foldynl/dds_sweeper/arduino/doc/antennenanalysator_m4_schematic.pdf

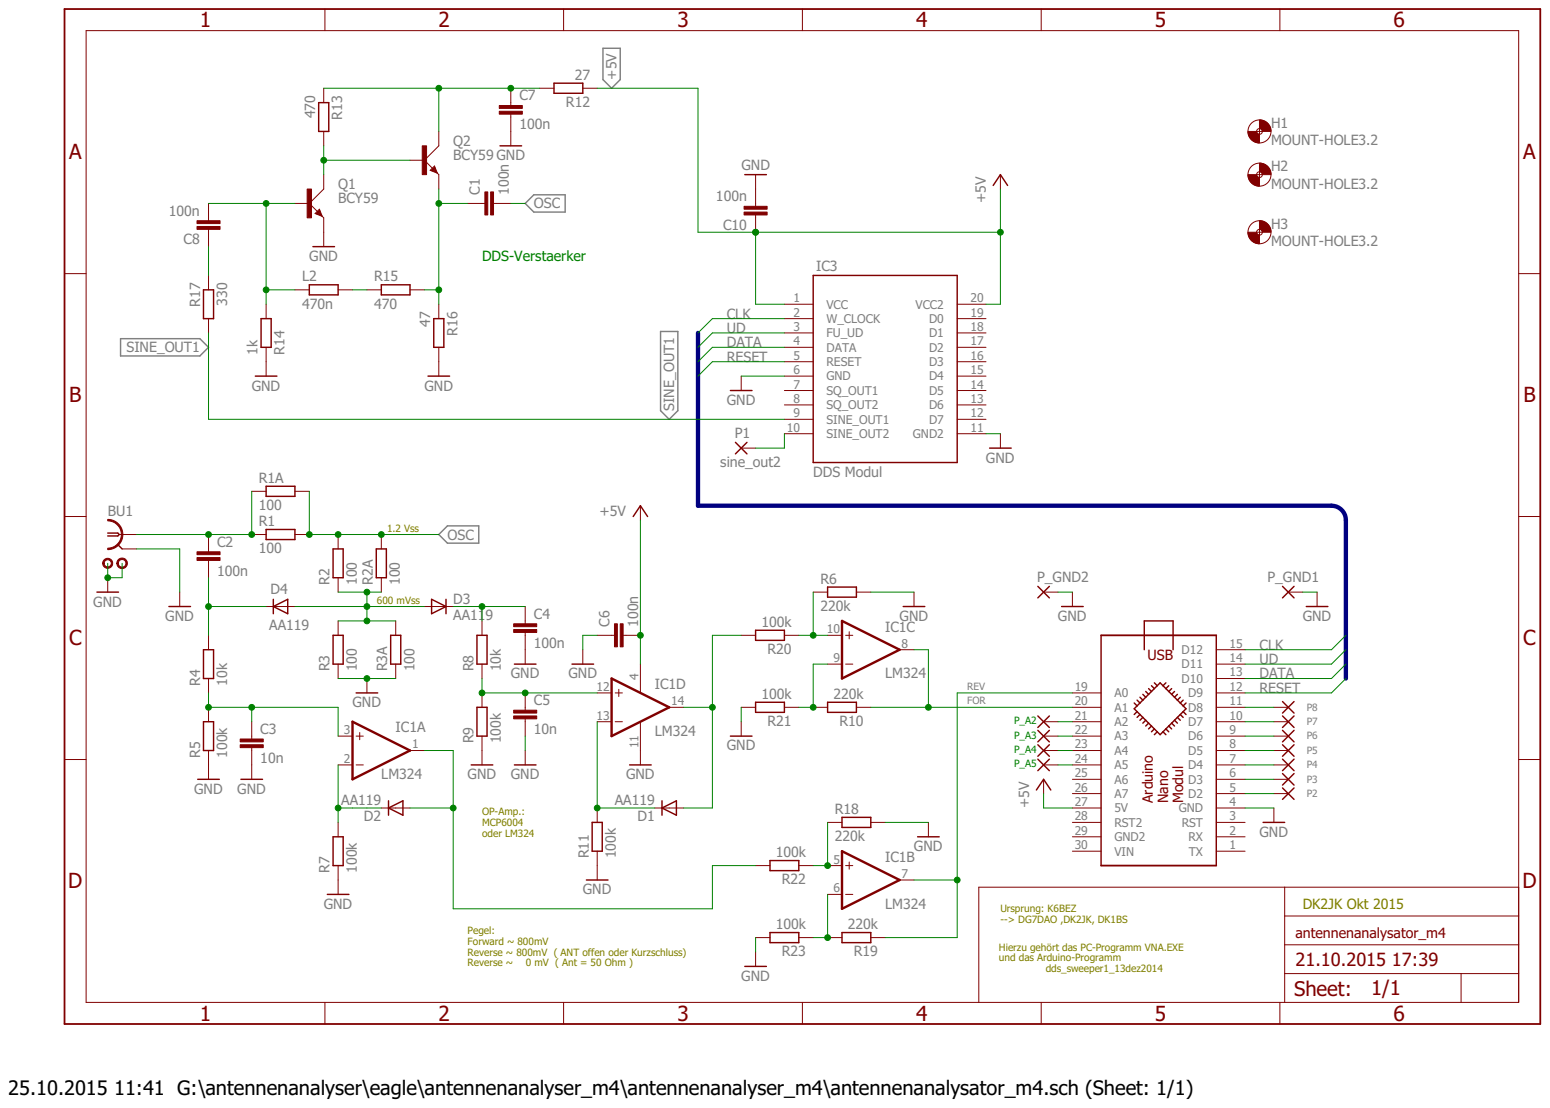
[picture p13: page 1]

Arduino Nano Modul USB

Ursprung: K6BEZ
--> DG7DAO ,DK2JK, DK1BS Hierzu gehört das PC-Programm VNA.EXE

und das Arduino-Programm

25.10.2015 11:41 G:\antennenanalyser\eagle\antennenanalyser_m4\antennenanalyser_m4\antennenanalysator_m4.sch (Sheet: 1/1)
