foldynl/dds_sweeper/arduino/doc/antennenanalysator_m4_board.pdf

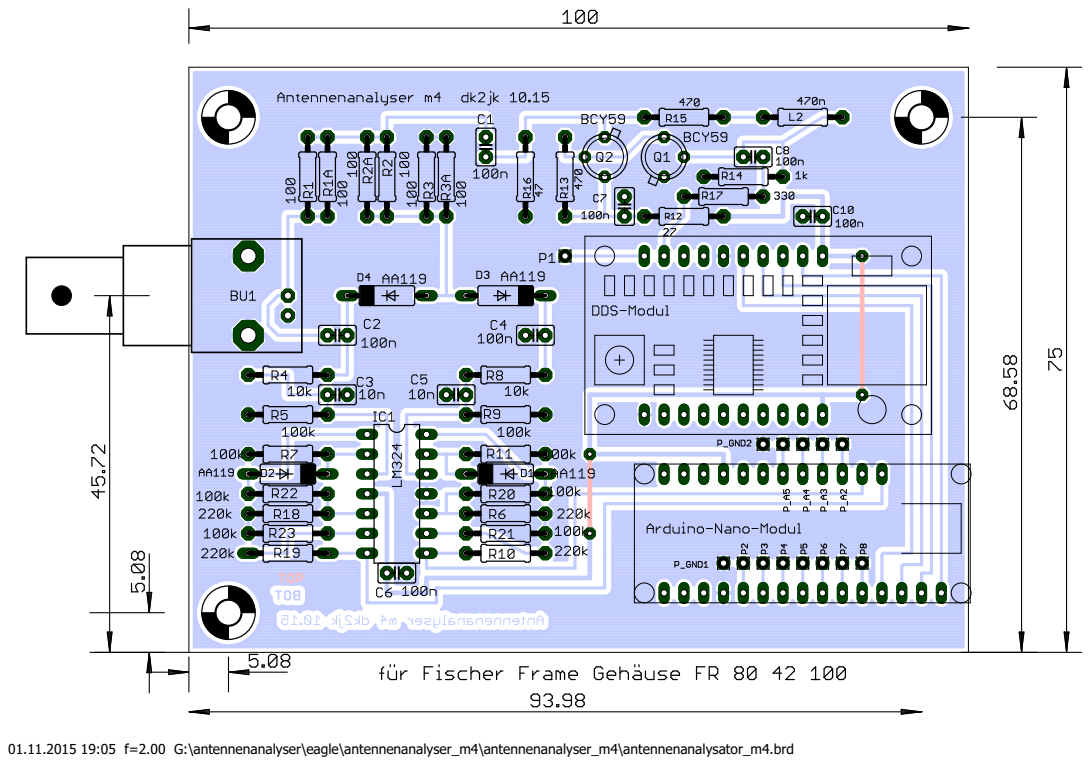
[picture p14: page 1]
