foldynl/dds_sweeper/(commit log)

2018-02-15 Import source code from an original project (dds_sweeper_2_2-16-212a)
    http://dk2jk.darc.de/arduino/antennenanalyser/prototyp_m4/
2018-02-16 Added Calibration support for SWR Reworked Analog Input Calibration Variable types optimalization 't' option was removed 'c' option was changed - new meaning 'f' new option - for SWR calibration
    [dds_sweeper.ino]
2018-02-16 Added Java Client.
    The Antenna Analyzer Client can show a graph of SWR
    The source code is not clean.
2018-02-21 Added Calibration utility
    for more details please see README.md file
