foldynl/dds_sweeper/(notices)

Notices in the files:
utils/calibration/calibration.py:
AntennaAnalyzer is free software: you can redistribute it and/or modify
it under the terms of either the Apache Software License, version 2, or
the GNU Lesser General Public License as published by the Free Software
License and the Apache Software License. If not,
see <http://www.gnu.org/licenses/> and <http://www.apache.org/licenses/>.
